smartboxchannel/epdiy/doc/003_3d.jpg

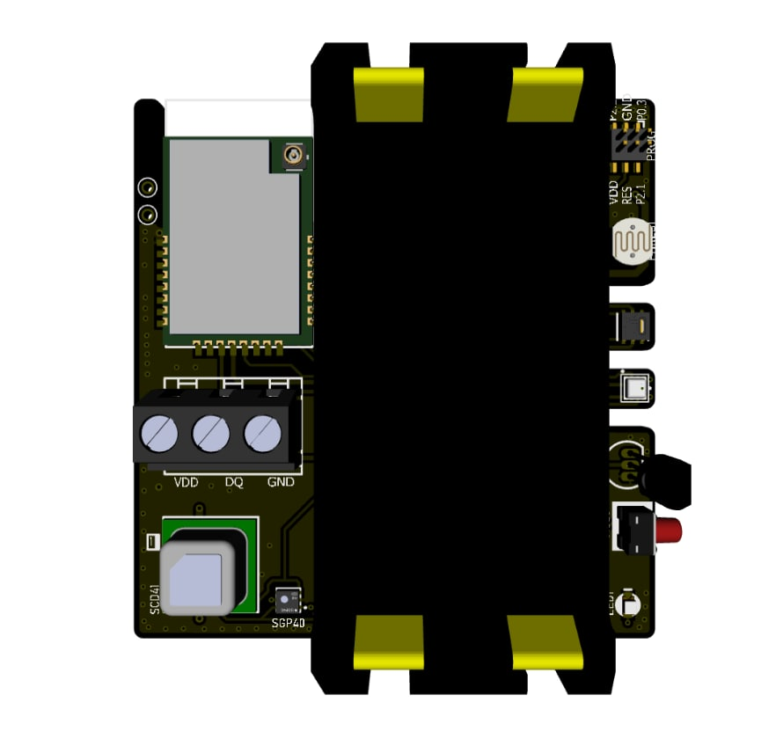
doc/003_3d.jpg
