smartboxchannel/epdiy/(commit log)

2020-12-21 v5: use ch340g with auto-reset
    [epaper-breakout.sch]
2020-12-22 xc5 connector, power management
    [epaper-breakout.sch]
2020-12-28 WIP: partial routing
    [epaper-breakout.kicad_pcb, epaper-breakout.sch]
2020-12-29 partial routing
    [epaper-breakout.kicad_pcb, epaper-breakout.sch]
2021-01-01 v5: lipo charger circuit
    [epaper-breakout.sch]
2021-01-01 v5 fix pin functions
    [epaper-breakout.sch]
2021-01-01 more routing
    [epaper-breakout.kicad_pcb, epaper-breakout.sch]
