smartboxchannel/epdiy/(notices)

Notices in the files:
hardware/epaper-breakout/epaper-breakout.sch:
License: CC-BY-4.0
parts and their libraries:
Copyright 2016 Accelerated Designs. All rights reserved.
